cameronspears/pria-5/docs/images/bass-nearfields.png

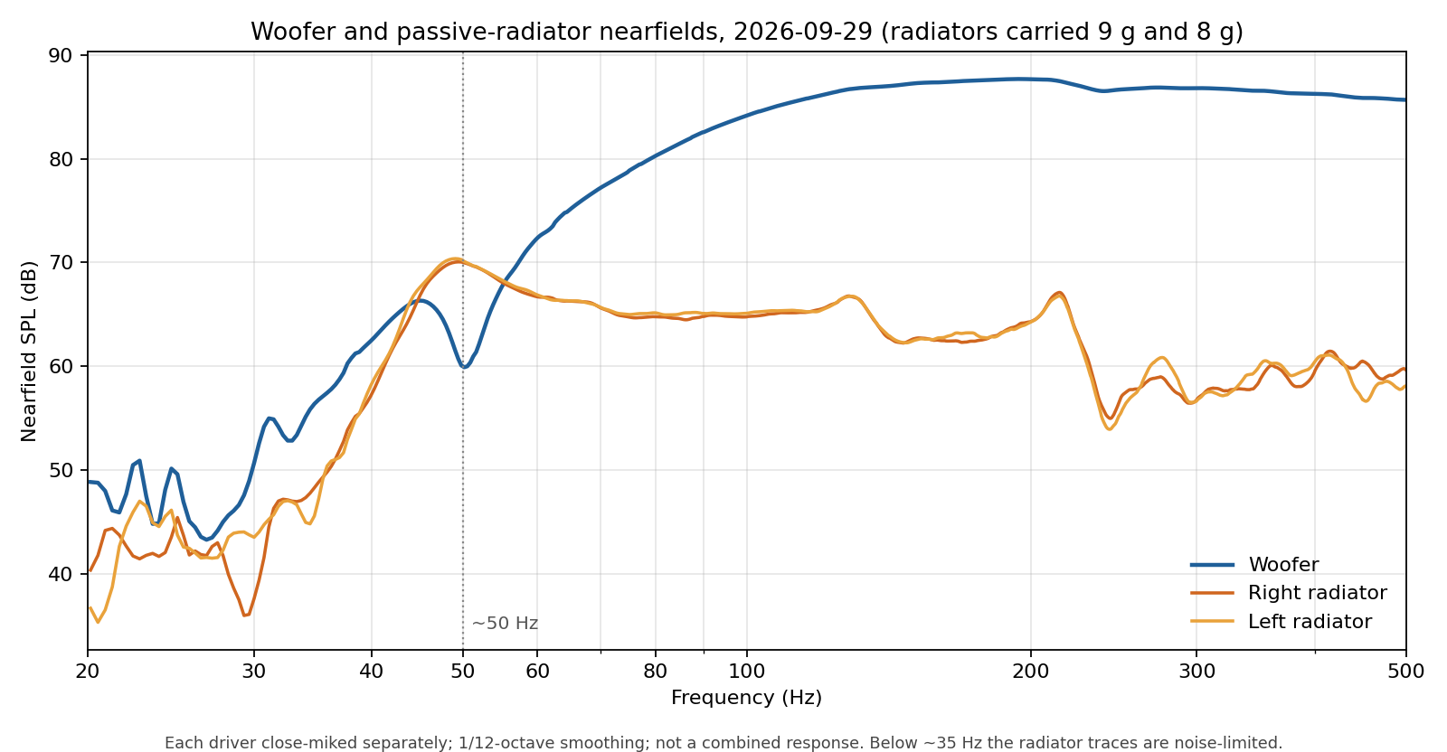
docs/images/bass-nearfields.png
