cameronspears/pria-5/docs/images/horizontal-30deg.png

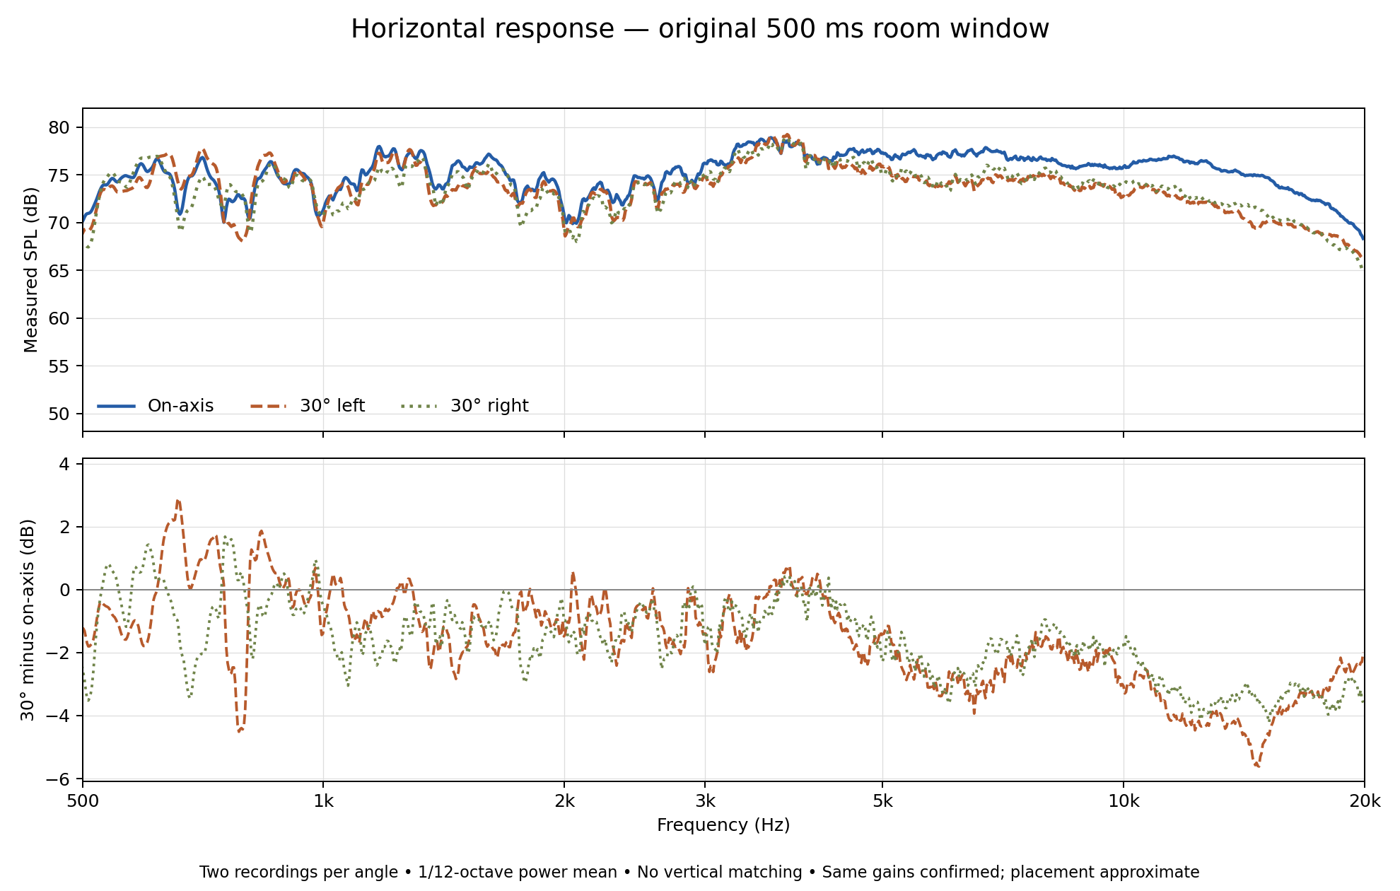
docs/images/horizontal-30deg.png
