cameronspears/pria-5/docs/images/tweeter-delay.png

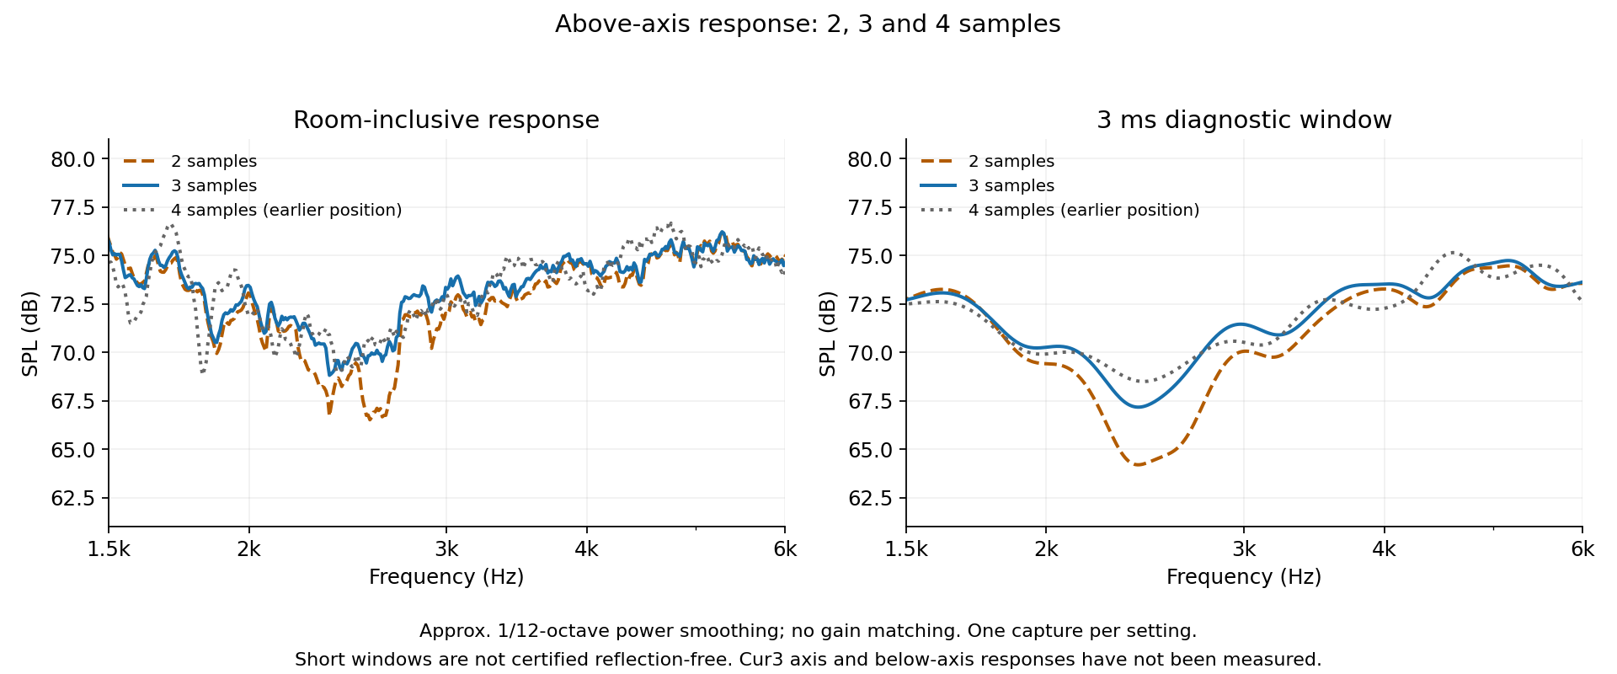
docs/images/tweeter-delay.png
