cameronspears/pria-5/simulation/crossover_study_2026-10-21/fig1_crossover.png

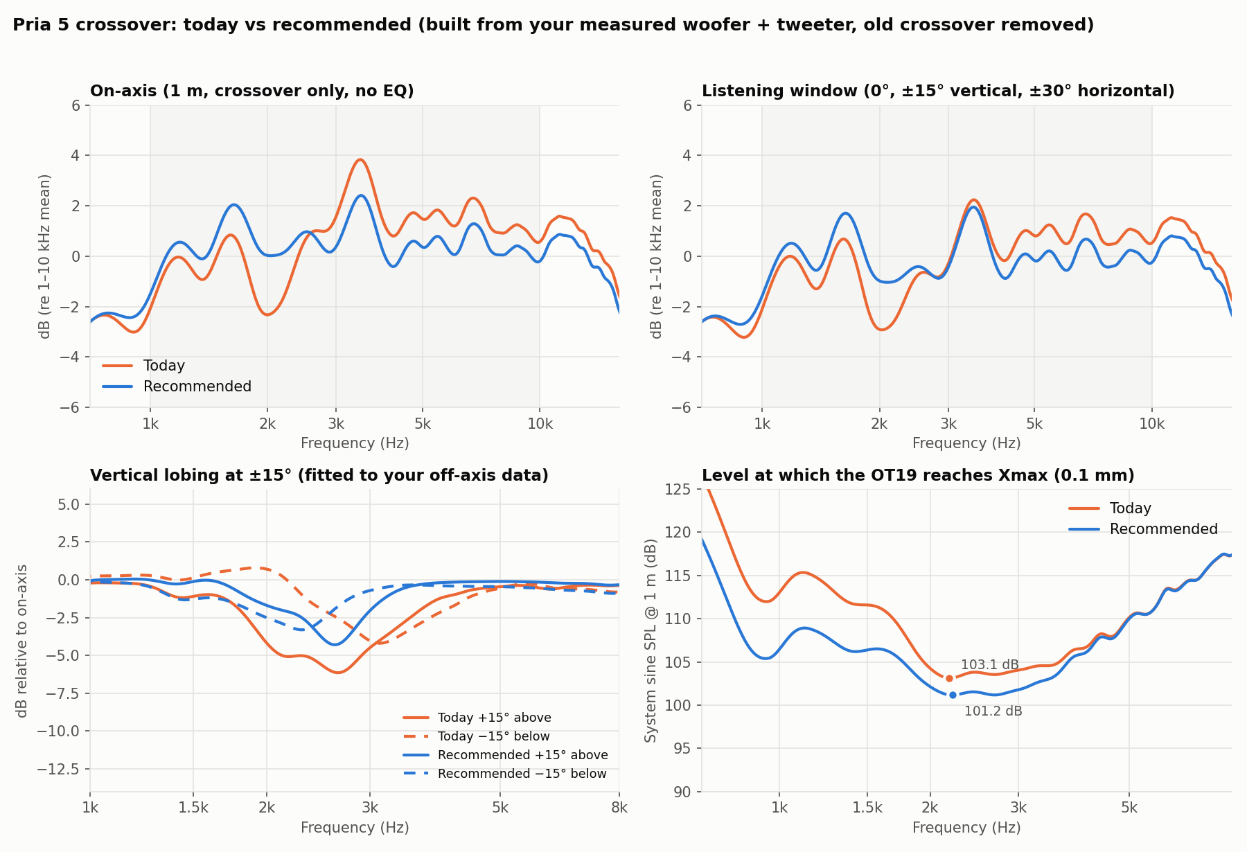
simulation/crossover_study_2026-10-21/fig1_crossover.png
