cameronspears/pria-5/simulation/crossover_study_2026-10-21/fig2_pr_mass.png

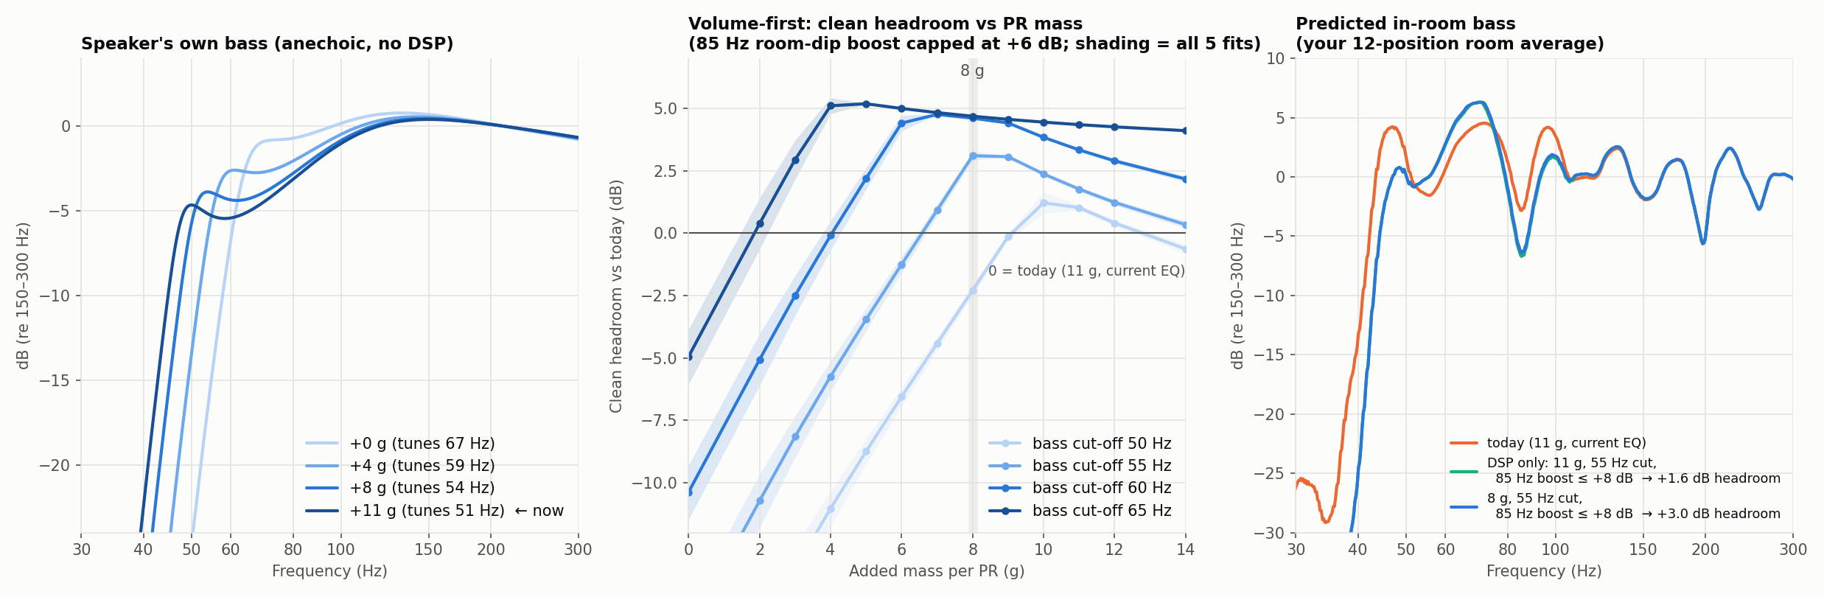
simulation/crossover_study_2026-10-21/fig2_pr_mass.png
