cameronspears/pria-5/simulation/crossover_study_2026-10-21/fig4_polarity_check.png

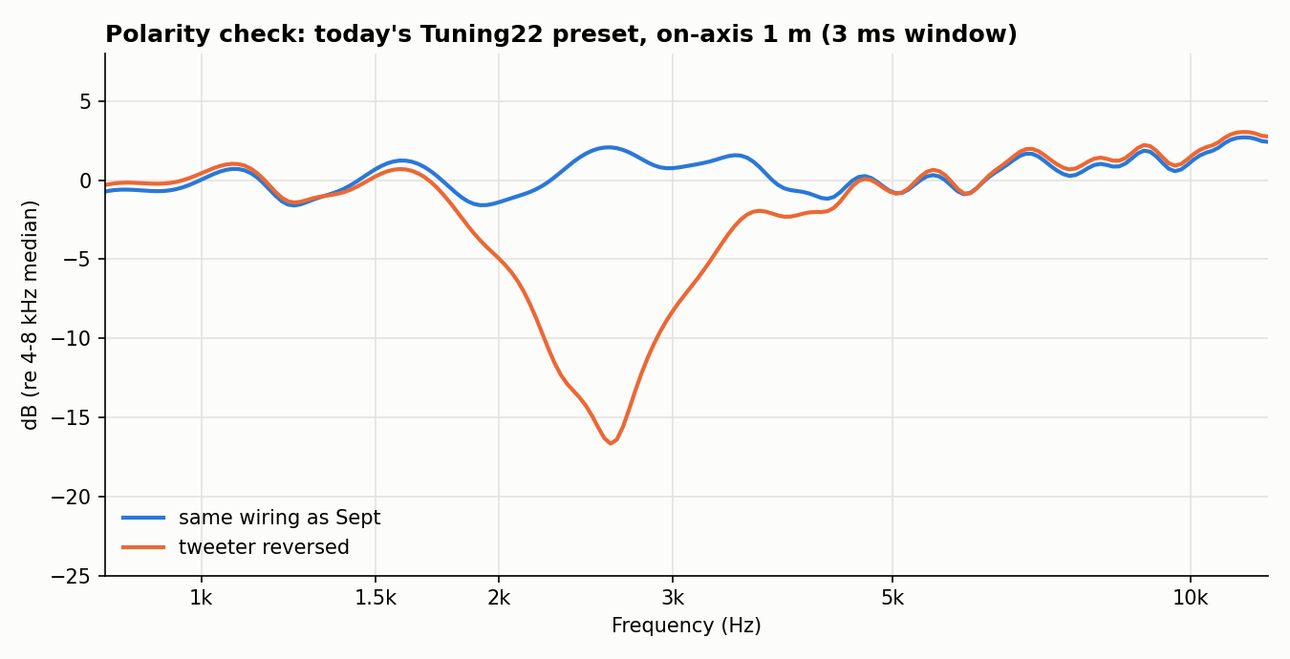
simulation/crossover_study_2026-10-21/fig4_polarity_check.png
