cameronspears/pria-5/simulation/system/full_frequency_response_comparison.png

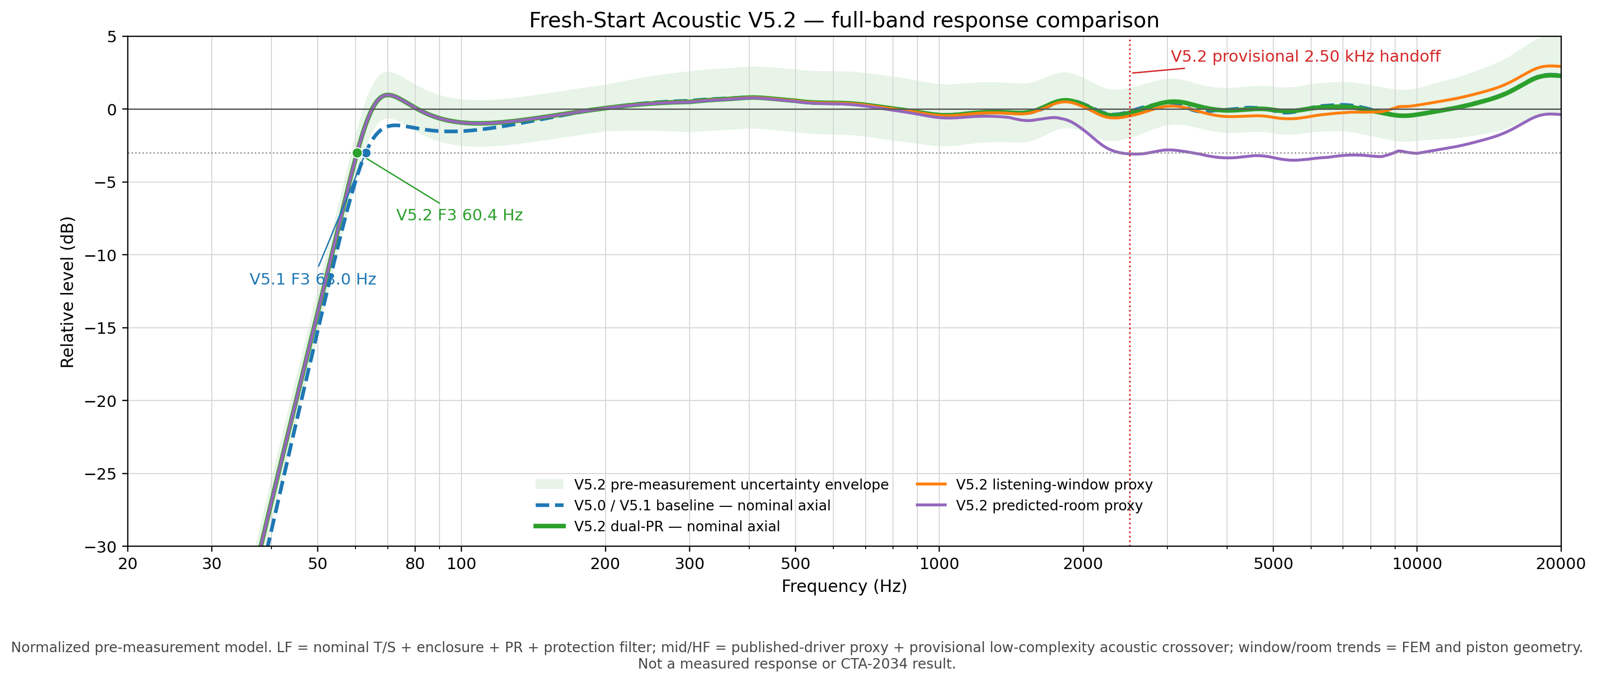
simulation/system/full_frequency_response_comparison.png
