cameronspears/pria-5/simulation/system/response_squeeze_v5_2.png

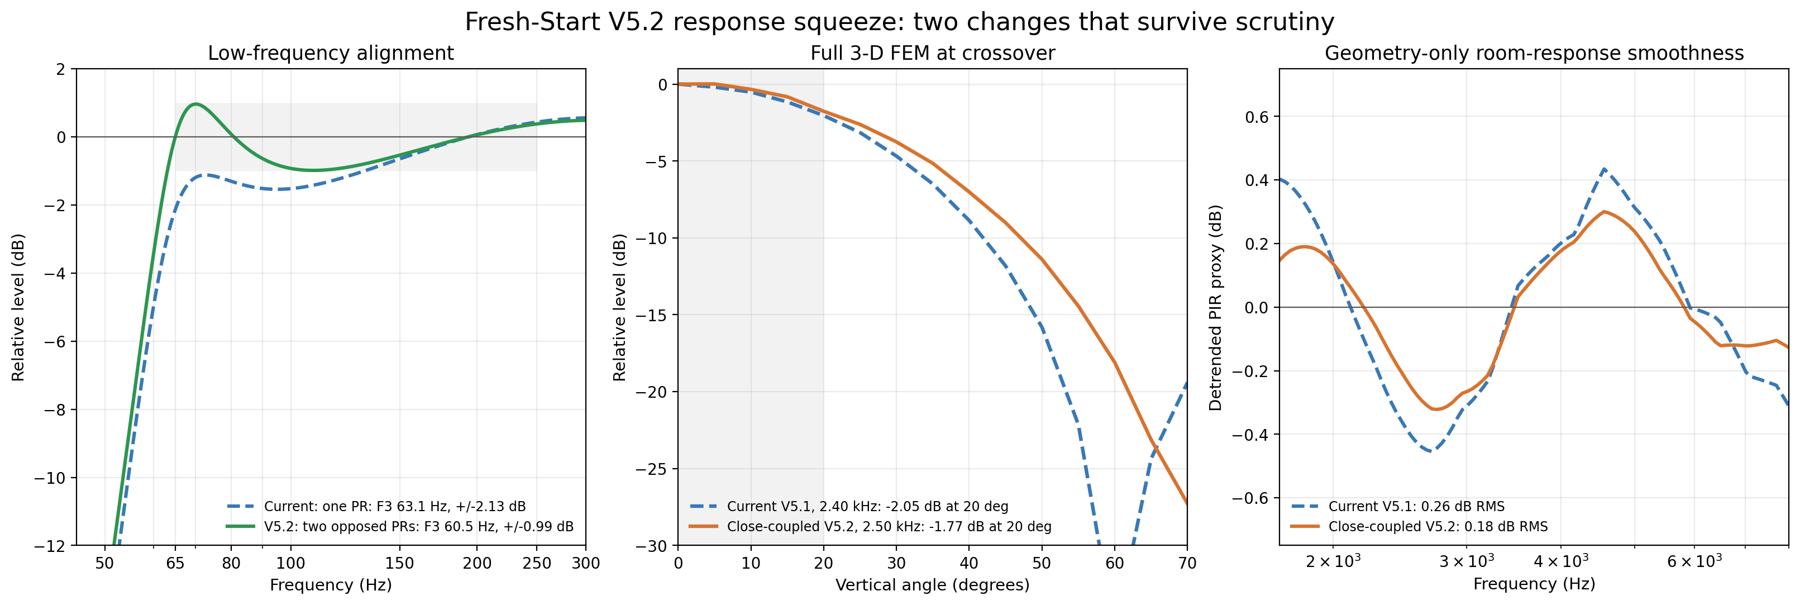
simulation/system/response_squeeze_v5_2.png
