cameronspears/pria-5/cad/bambu/Pria5_Baffle_ONLY_TABBED_pockets_ORANGE_pause44.3mf

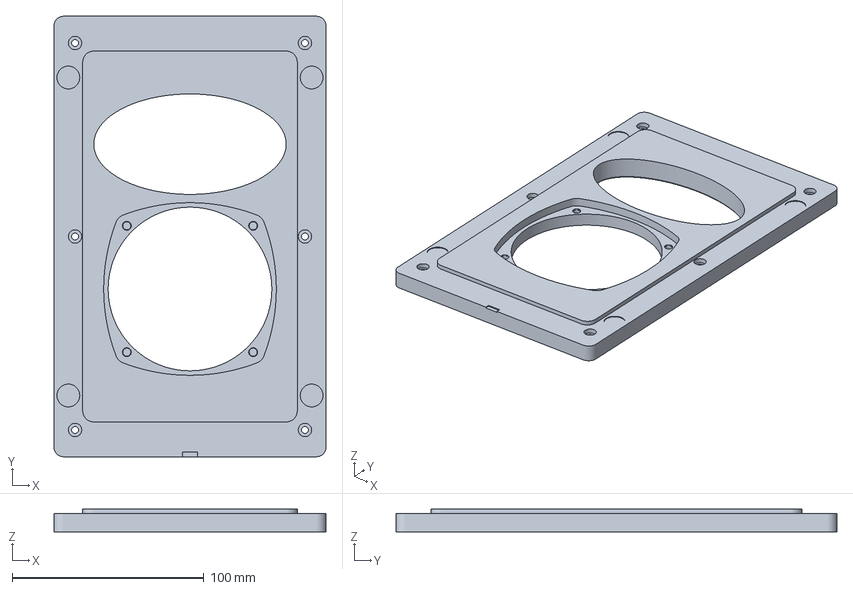
[picture p24: CAD file, 2026-10-29]
cad/bambu/Pria5_Baffle_ONLY_TABBED_pockets_ORANGE_pause44.3mf
142.0 x 230.0 x 12.0 mm
