cameronspears/pria-5/cad/gaskets/gasket_cut_template_1to1.dxf

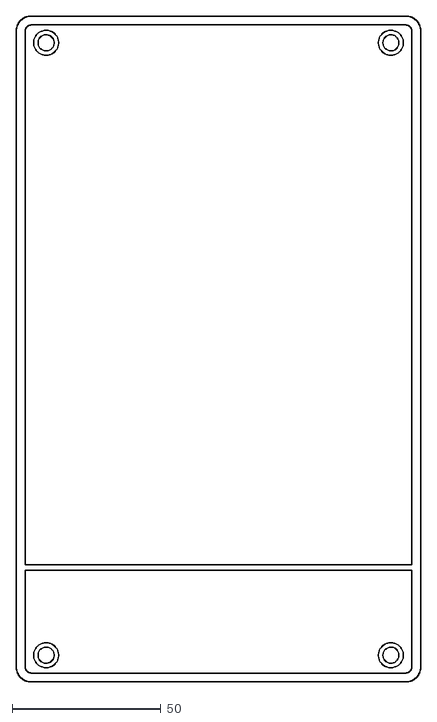
[picture p25: CAD file, 2026-10-29]
cad/gaskets/gasket_cut_template_1to1.dxf
136.0 x 224.0
