cameronspears/pria-5/cad/optional_checks/Optional_Recess_Release_Check.stl

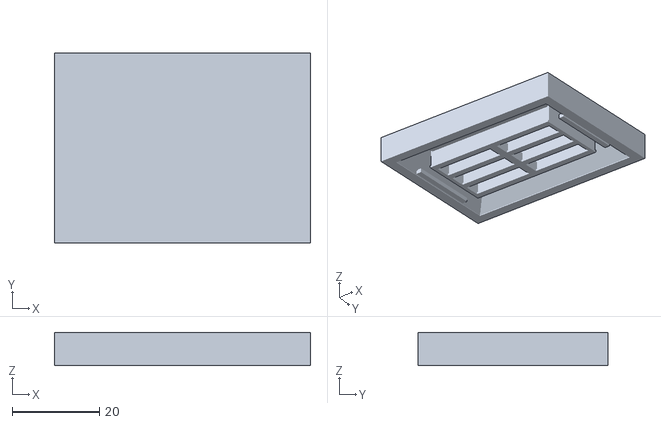
[picture p26: CAD file, 2026-10-29]
cad/optional_checks/Optional_Recess_Release_Check.stl
58.6 x 43.6 x 7.60
