cameronspears/pria-5/cad/parts/magnet_seating_tool.stl

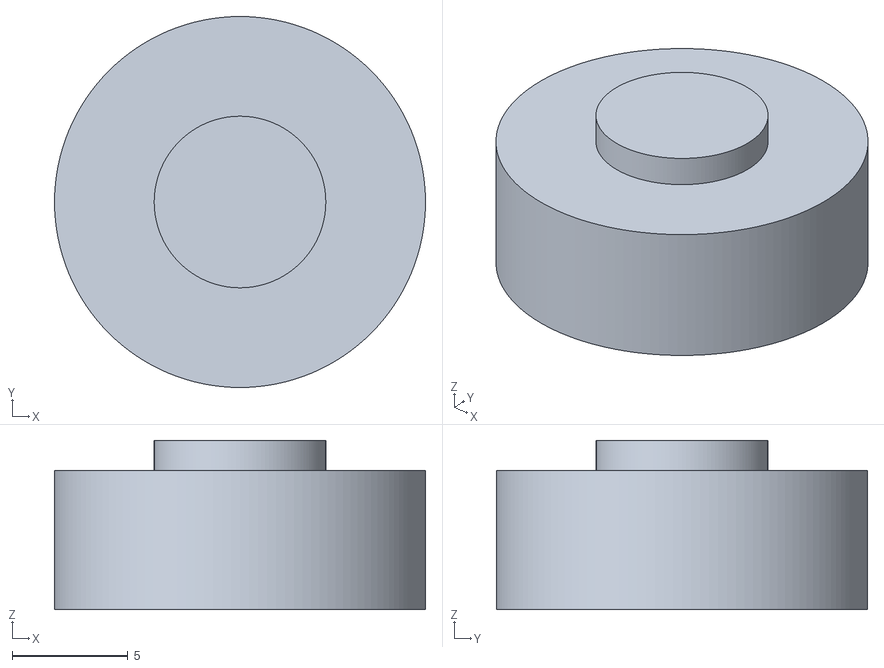
[picture p27: CAD file, 2026-10-29]
cad/parts/magnet_seating_tool.stl
16.0 x 16.0 x 7.30
