cameronspears/pria-5/cad/plates/Plate_2_Orange_MAGNETIC_FRAME_LOOSE_MAGNET_POCKETS_NO_BRIM.stl

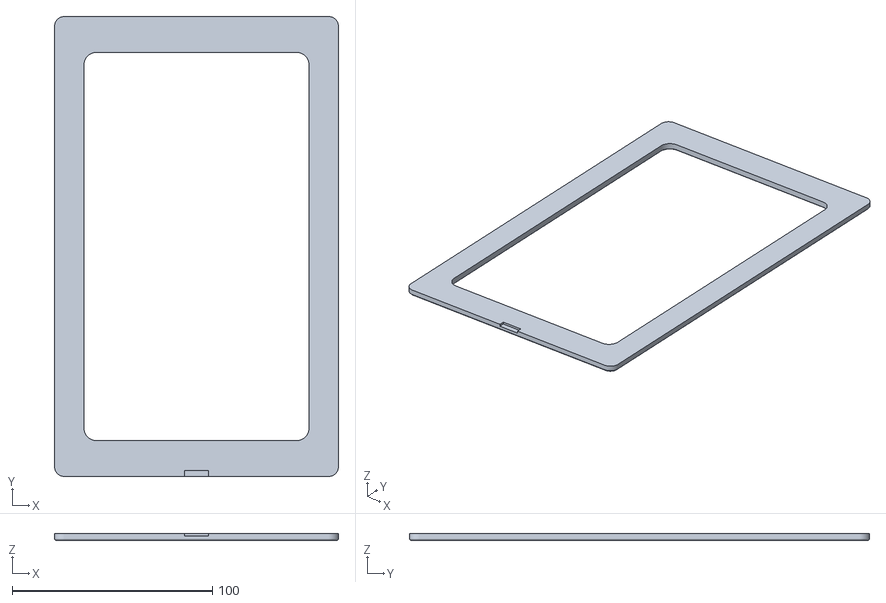
[picture p28: CAD file, 2026-10-29]
cad/plates/Plate_2_Orange_MAGNETIC_FRAME_LOOSE_MAGNET_POCKETS_NO_BRIM.stl
142.0 x 230.0 x 3.60
