cameronspears/pria-5/cad/stand/Desk_Stand_Tilt_18deg_NO_BRIM.stl

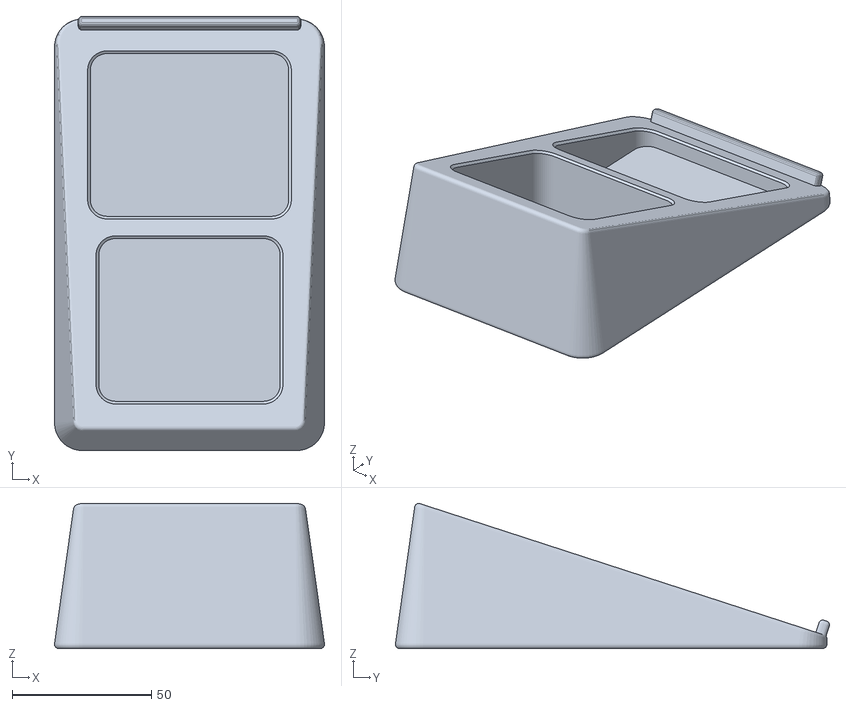
[picture p29: CAD file, 2026-10-29]
cad/stand/Desk_Stand_Tilt_18deg_NO_BRIM.stl
97.0 x 155.9 x 52.1
