cameronspears/pria-5/cad/bambu/Pria5_Plate1_Baffle_TABBED_pockets_R4_32_retainer_R4_35_wire_plate_ORANGE_pause44.3mf

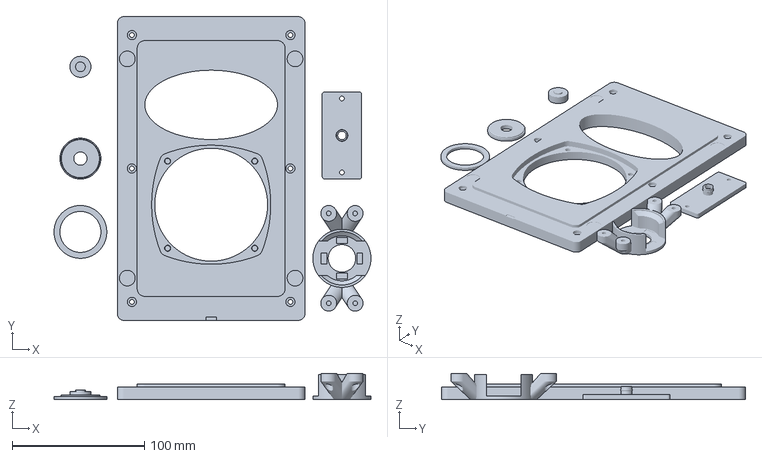
[picture p30: CAD file, 2026-10-29]
cad/bambu/Pria5_Plate1_Baffle_TABBED_pockets_R4_32_retainer_R4_35_wire_plate_ORANGE_pause44.3mf
240.0 x 230.0 x 19.9 mm
