cameronspears/pria-5/cad/optional_checks/Optional_Sealed_Magnet_Check.stl

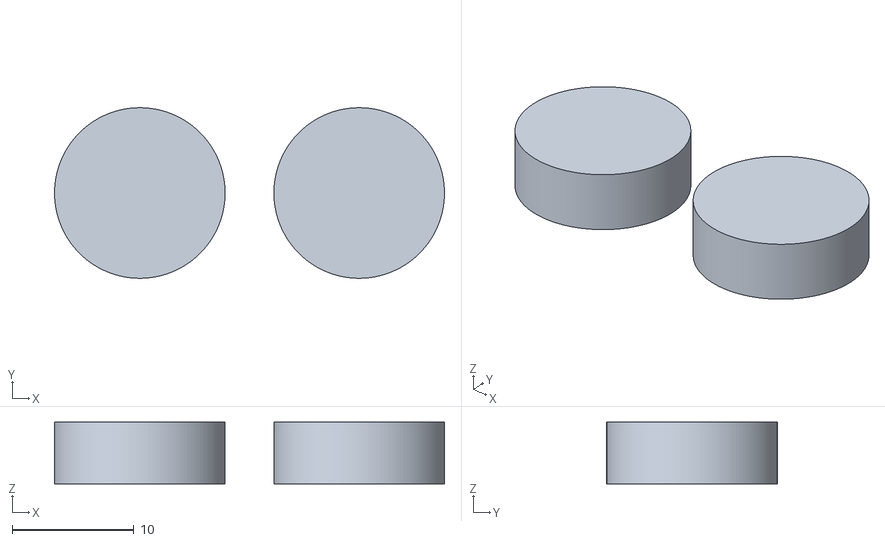
[picture p31: CAD file, 2026-10-29]
cad/optional_checks/Optional_Sealed_Magnet_Check.stl
32.0 x 14.0 x 5.05
