cameronspears/pria-5/cad/parts/retainer.stl

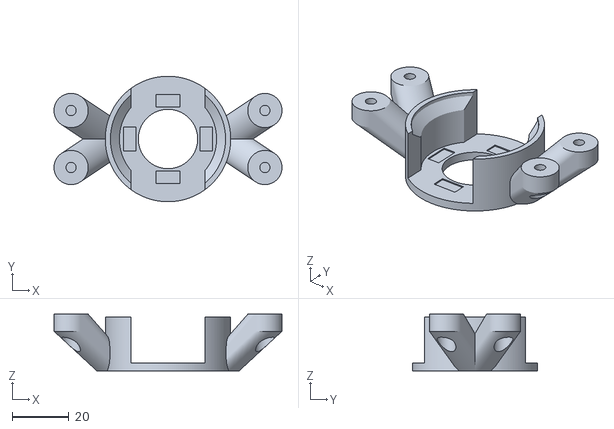
[picture p32: CAD file, 2026-10-29]
cad/parts/retainer.stl
80.0 x 44.0 x 19.9
