cameronspears/pria-5/cad/plates/Plate_4_Rear_GRILLE_VENTS_NO_BRIM.stl

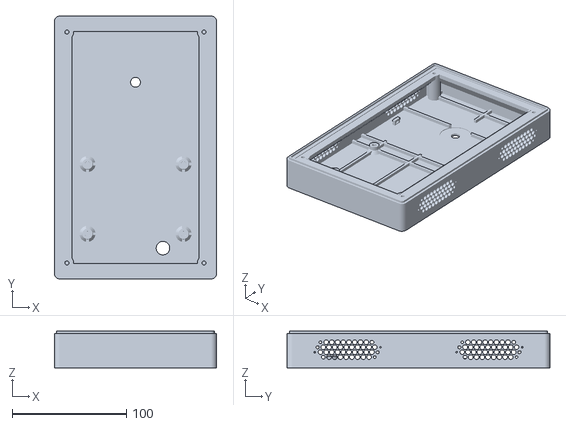
[picture p33: CAD file, 2026-10-29]
cad/plates/Plate_4_Rear_GRILLE_VENTS_NO_BRIM.stl
142.0 x 230.0 x 32.0
