cameronspears/pria-5/cad/stand/Desk_Stand_Tilt_15deg_NO_BRIM.stl

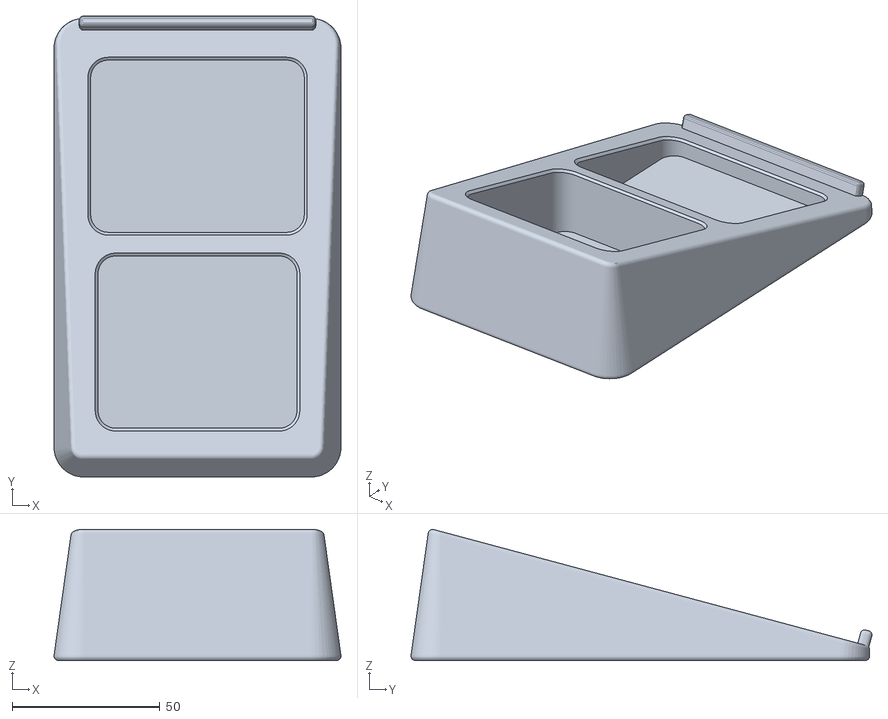
[picture p34: CAD file, 2026-10-29]
cad/stand/Desk_Stand_Tilt_15deg_NO_BRIM.stl
97.0 x 155.8 x 44.3
