cameronspears/pria-5/cad/bambu/Pria5_Tweeter_Retainer_R4_32_and_Shims.3mf

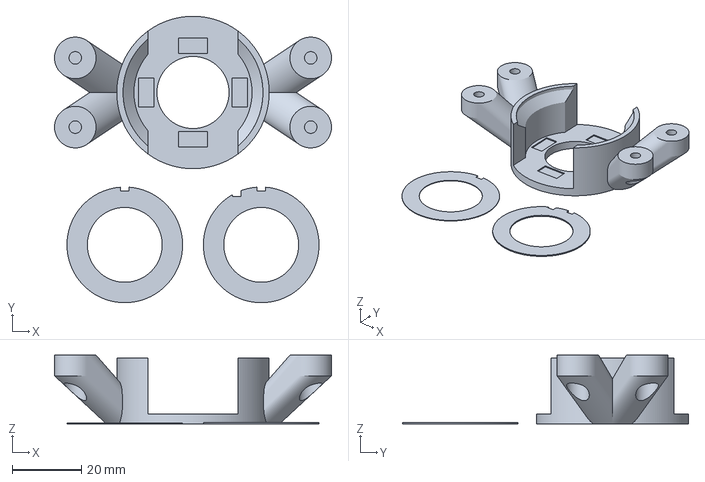
[picture p35: CAD file, 2026-10-29]
cad/bambu/Pria5_Tweeter_Retainer_R4_32_and_Shims.3mf
80.0 x 82.7 x 19.9 mm
