cameronspears/pria-5/cad/plates/Plate_5_Black_Woofer_Cover_Waveguide_NO_BRIM.stl

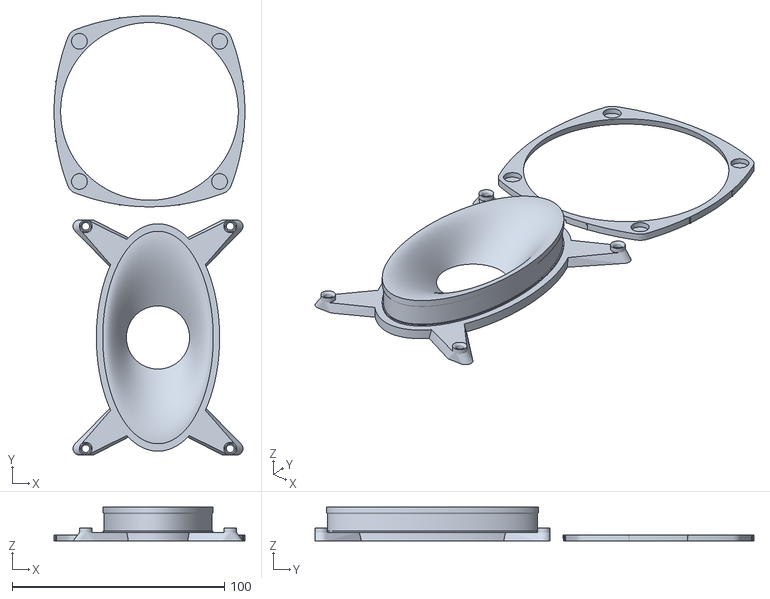
[picture p36: CAD file, 2026-10-29]
cad/plates/Plate_5_Black_Woofer_Cover_Waveguide_NO_BRIM.stl
89.8 x 206.6 x 16.0
