cameronspears/pria-5/cad/stand/Desk_Stand_Tilt_22deg_NO_BRIM.stl

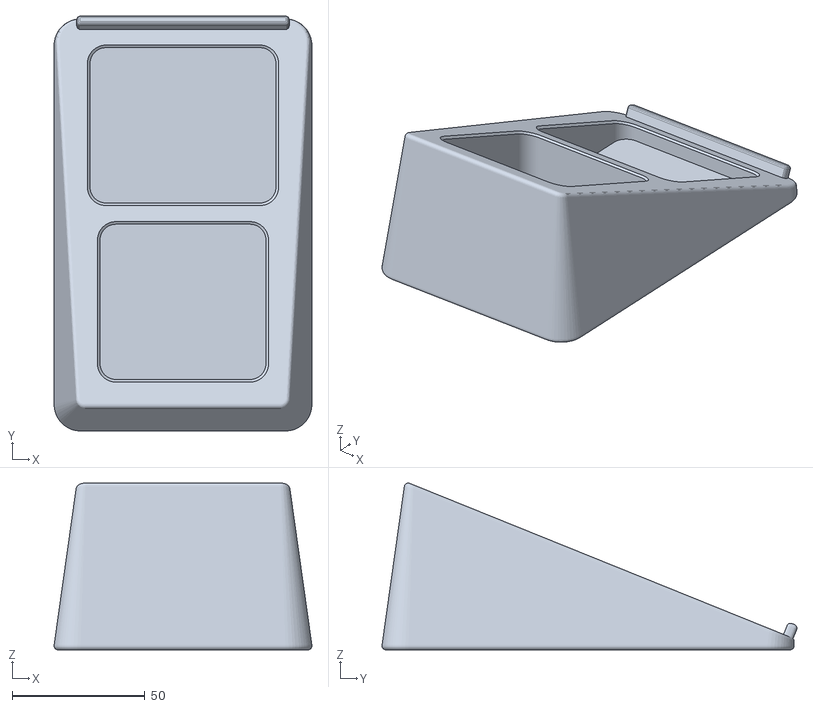
[picture p37: CAD file, 2026-10-29]
cad/stand/Desk_Stand_Tilt_22deg_NO_BRIM.stl
97.0 x 156.1 x 62.7
