cameronspears/pria-5/cad/bambu/Pria5_Wire_Plate_D6p4_HOT_GLUE_CUP_with_CHANNEL_R4_35.3mf

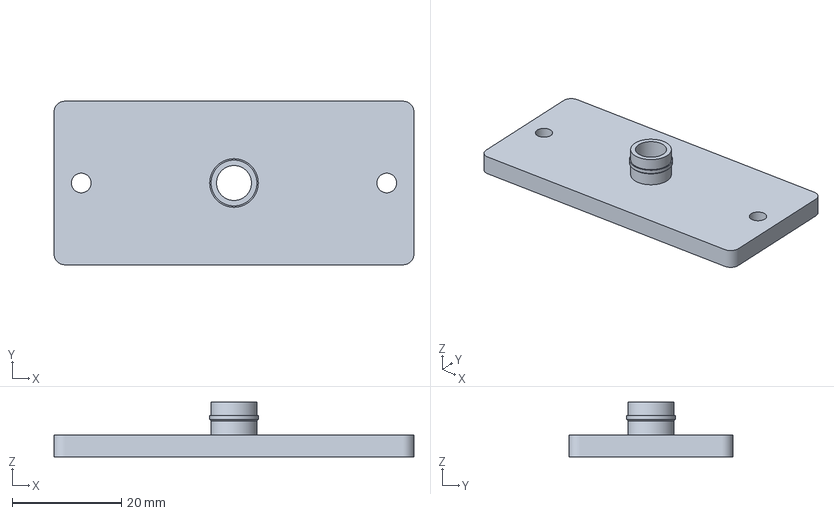
[picture p38: CAD file, 2026-10-29]
cad/bambu/Pria5_Wire_Plate_D6p4_HOT_GLUE_CUP_with_CHANNEL_R4_35.3mf
66.0 x 30.0 x 10.0 mm
