cameronspears/pria-5/cad/parts/gasket_alignment.stl

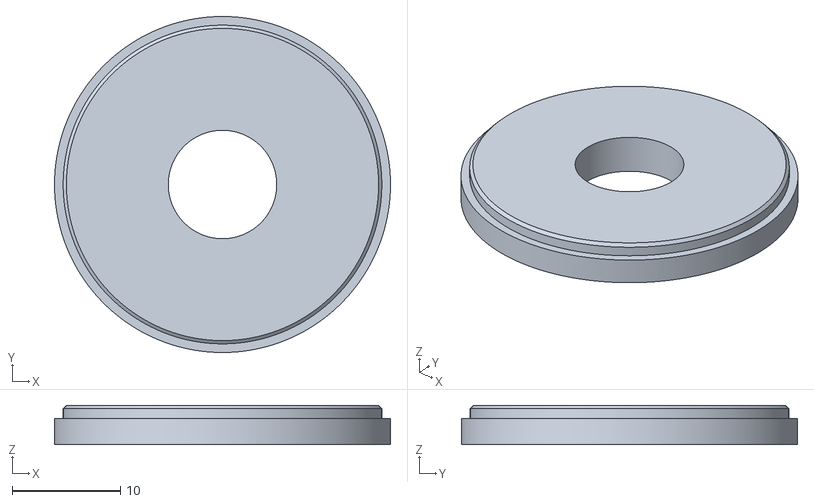
[picture p39: CAD file, 2026-10-29]
cad/parts/gasket_alignment.stl
31.0 x 31.0 x 3.60
