cameronspears/pria-5/cad/plates/Plate_3_Body_BRACED_PR_KEYS_and_3_COMBS_NO_BRIM.stl

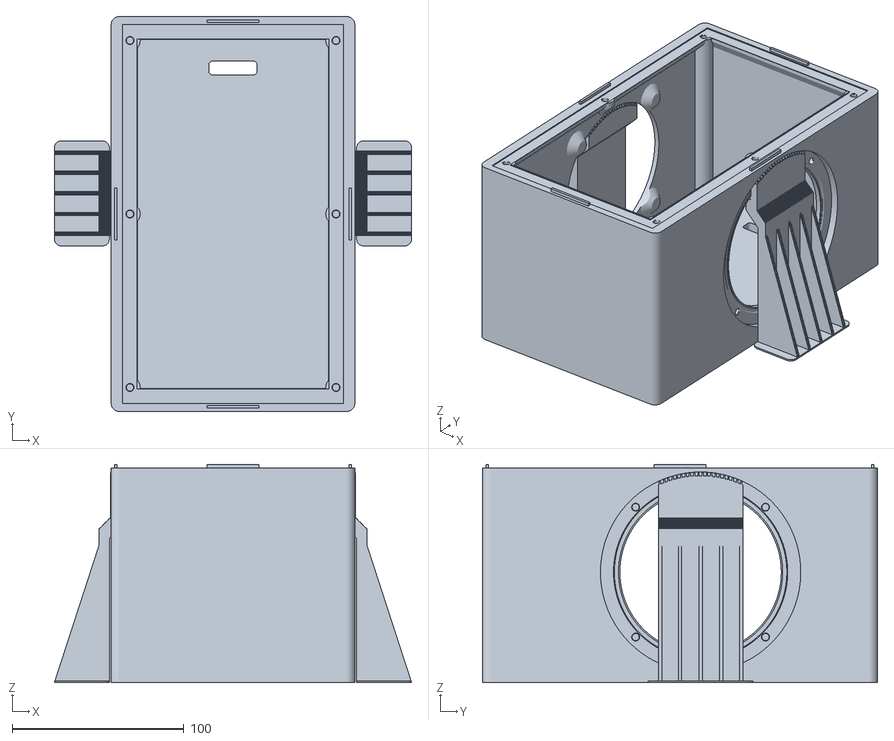
[picture p40: CAD file, 2026-10-29]
cad/plates/Plate_3_Body_BRACED_PR_KEYS_and_3_COMBS_NO_BRIM.stl
208.0 x 230.0 x 127.0
