cameronspears/pria-5/cad/bambu/Pria5_Woofer_Cover_ONLY.3mf

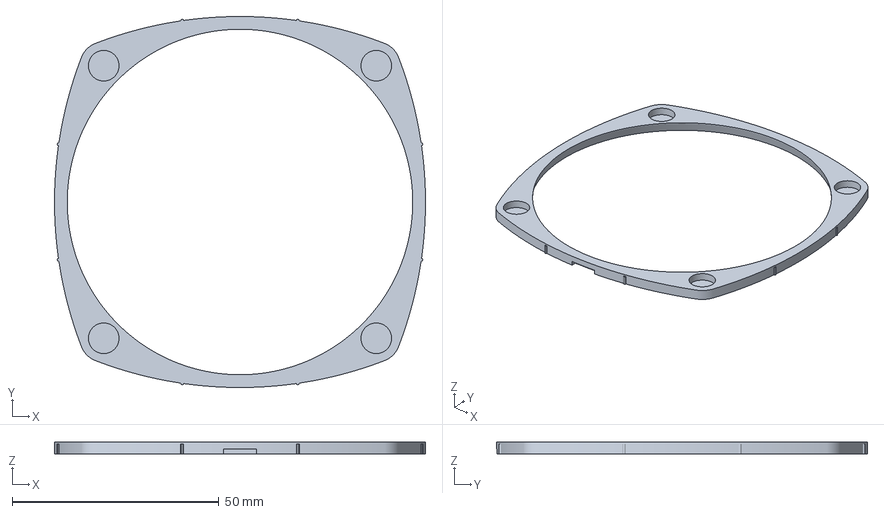
[picture p41: CAD file, 2026-10-29]
cad/bambu/Pria5_Woofer_Cover_ONLY.3mf
89.8 x 89.8 x 2.90 mm
