cameronspears/pria-5/cad/parts/waveguide.stl

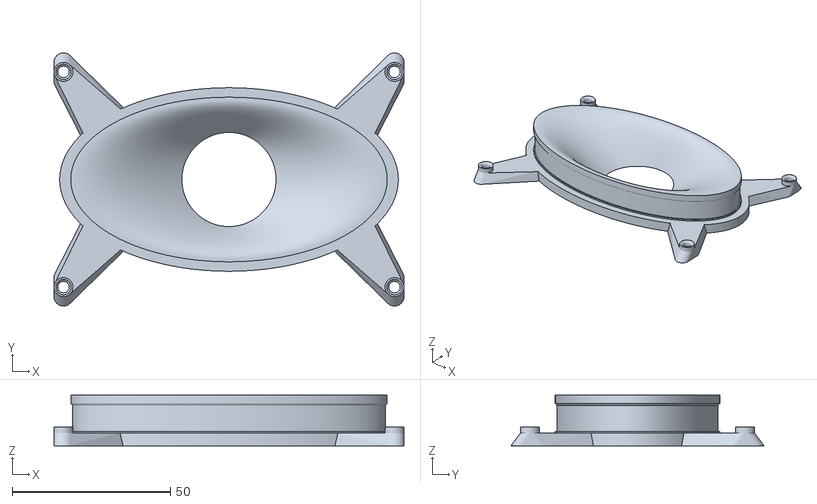
[picture p42: CAD file, 2026-10-29]
cad/parts/waveguide.stl
110.6 x 80.0 x 16.0
