cameronspears/pria-5/cad/parts/gasket_template.stl

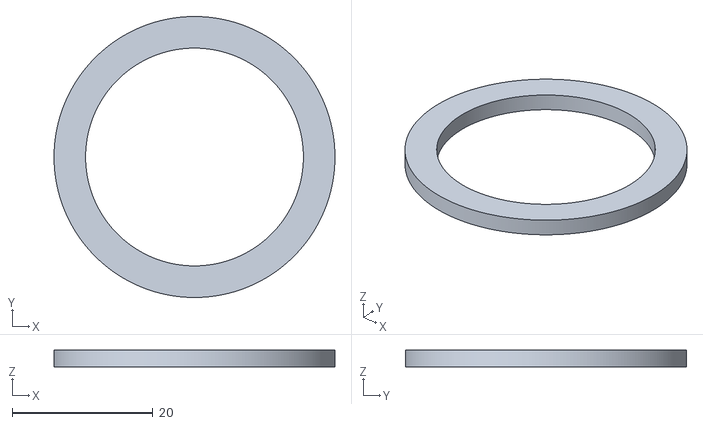
[picture p43: CAD file, 2026-10-29]
cad/parts/gasket_template.stl
40.0 x 40.0 x 2.40
