cameronspears/pria-5/cad/parts/tweeter_shims_0p2_and_0p4.stl

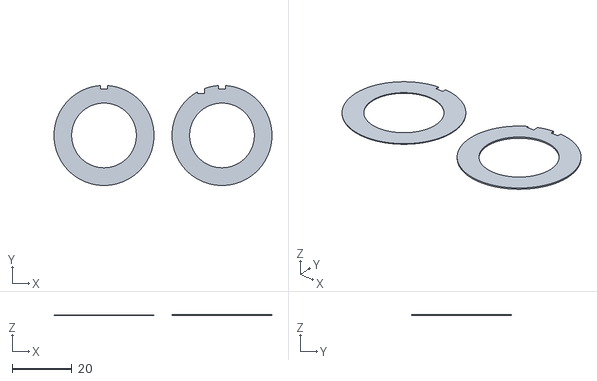
[picture p44: CAD file, 2026-10-29]
cad/parts/tweeter_shims_0p2_and_0p4.stl
72.8 x 33.4 x 0.4
