cameronspears/pria-5/(list of files, cad)

Other CAD files:
cad/plates/Plate_1_Orange_Baffle_R4_32_Retainer_R4_35_Wire_Plate_TABBED_MAGNET_POCKETS_and_SEATING_TOOL_NO_BRIM.stl
cad/bambu/Pria5_Plate2_Magnetic_Frame_ORANGE_pause17.3mf
cad/parts/baffle.stl
cad/parts/woofer_cover.stl
cad/parts/wire_plate.stl
