cameronspears/pria-5/simulation/waveguide/v5_2_close_coupled_ellipse_3d_confirmation.png

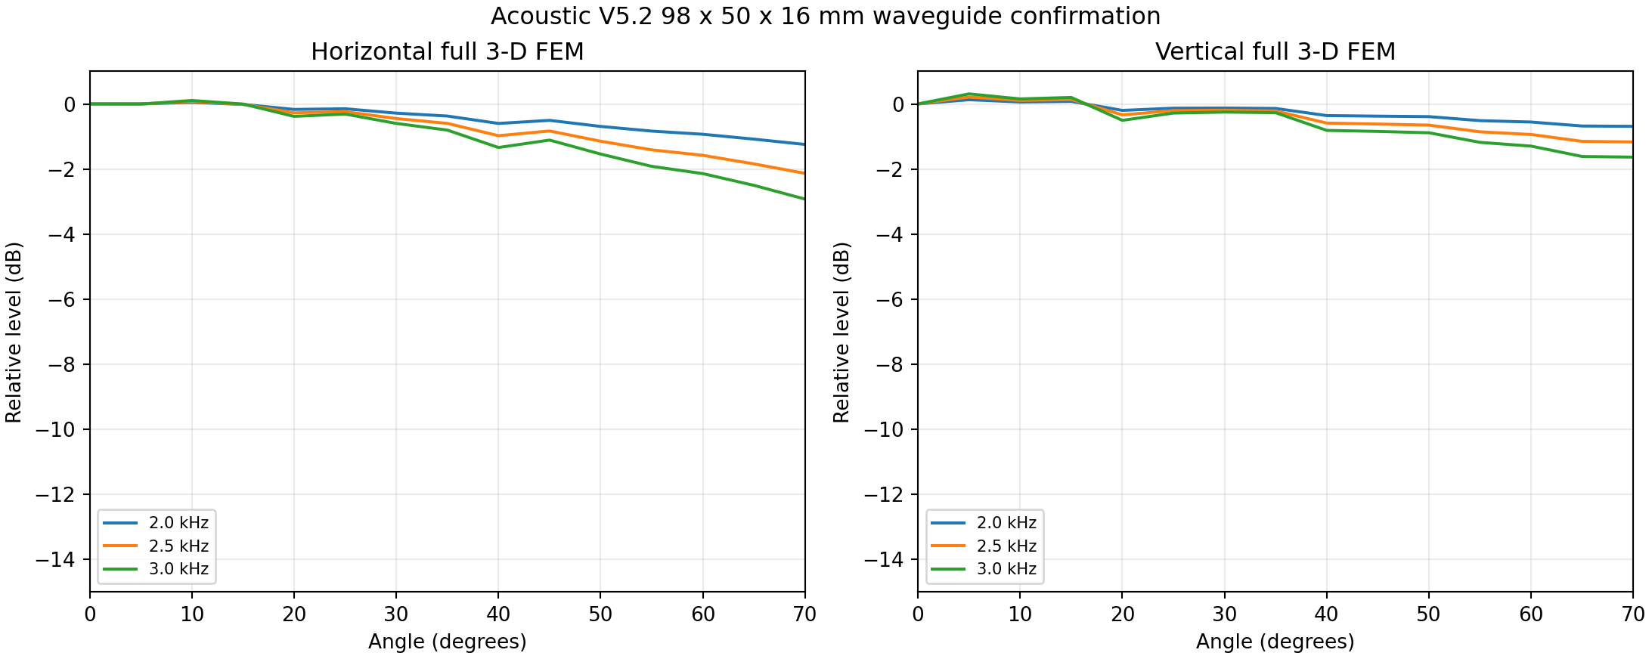
simulation/waveguide/v5_2_close_coupled_ellipse_3d_confirmation.png
