cameronspears/pria-5/dsp/tuning22/tuning22_eq.csv

block | row_1_based | type | frequency_hz | q | boost_db | gain_db | bypass
Woofer EQ | 1 | High-pass | 50.0 | 0.71 | 0.0 | 0.0 | False
Woofer EQ | 2 | High-pass | 50.0 | 0.71 | 0.0 | 0.0 | False
Woofer EQ | 3 | Peaking | 58.0 | 1.0 | 7.5 | 0.0 | False
Woofer EQ | 4 | Peaking | 69.0 | 5.0 | -9.0 | 0.0 | False
Woofer EQ | 5 | Peaking | 70.0 | 0.7 | 9.0 | 0.0 | False
Woofer EQ | 6 | Peaking | 92.0 | 2.0 | 3.0 | 0.0 | False
Woofer EQ | 7 | Peaking | 143.0 | 3.0 | -7.5 | 0.0 | False
Woofer EQ | 8 | Peaking | 220.0 | 3.5 | -4.75 | 0.0 | False
Woofer EQ | 9 | Peaking | 350.0 | 3.0 | -1.25 | 0.0 | False
Woofer EQ | 10 | Peaking | 680.0 | 3.0 | -3.75 | 0.0 | False
Woofer EQ | 11 | Peaking | 1220.0 | 6.0 | -4.0 | 0.0 | False
Woofer EQ | 12 | Peaking | 1690.0 | 1.9 | -3.0 | 0.0 | False
Woofer EQ | 13 | Peaking | 3300.0 | 3.2 | -2.0 | 0.0 | False
Woofer EQ | 14 | Peaking | 5200.0 | 1.1 | -4.0 | 0.0 | False
Woofer EQ | 15 | Peaking | 10000.0 | 0.5 | -2.5 | 0.0 | False
Tweeter EQ | 1 | Peaking | 58.0 | 1.0 | 7.5 | 0.0 | False
Tweeter EQ | 2 | Peaking | 69.0 | 5.0 | -9.0 | 0.0 | False
Tweeter EQ | 3 | Peaking | 92.0 | 2.0 | 3.0 | 0.0 | False
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
