cameronspears/pria-5/measurements/bass_nearfields_2026-09-29/left_radiator.csv

frequency_hz | nearfield_spl_db | phase_degrees
2.014160156250000000e+01 | 3.628164672851562500e+01 | -1.309374542236328125e+02
2.050781250000000000e+01 | 3.704826736450195312e+01 | -7.148912048339843750e+01
2.087402343750000000e+01 | 3.258446502685546875e+01 | -7.320524215698242188e+00
2.124023437500000000e+01 | 3.986587142944335938e+01 | 6.063074493408203125e+01
2.160644531250000000e+01 | 4.371092987060546875e+01 | 6.037001800537109375e+01
2.197265625000000000e+01 | 4.428966140747070312e+01 | 3.609401702880859375e+01
2.233886718750000000e+01 | 4.573925781250000000e+01 | -6.408696770668029785e-01
2.270507812500000000e+01 | 4.772644042968750000e+01 | -2.270698165893554688e+01
2.307128906250000000e+01 | 4.748892593383789062e+01 | -2.825422286987304688e+01
2.343750000000000000e+01 | 4.430445480346679688e+01 | -1.339805793762207031e+01
2.380371093750000000e+01 | 4.292855834960937500e+01 | 3.850396728515625000e+01
2.416992187500000000e+01 | 4.638453292846679688e+01 | 6.624150848388671875e+01
2.453613281250000000e+01 | 4.724806213378906250e+01 | 6.830274963378906250e+01
2.490234375000000000e+01 | 4.473060989379882812e+01 | 5.678084182739257812e+01
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
