cameronspears/pria-5/measurements/bass_nearfields_2026-09-29/right_radiator.csv

frequency_hz | nearfield_spl_db | phase_degrees
2.014160156250000000e+01 | 3.733570861816406250e+01 | 7.368163299560546875e+01
2.050781250000000000e+01 | 4.334106063842773438e+01 | 9.288954162597656250e+01
2.087402343750000000e+01 | 4.459657669067382812e+01 | 1.137625656127929688e+02
2.124023437500000000e+01 | 4.455698776245117188e+01 | 1.364249572753906250e+02
2.160644531250000000e+01 | 4.392259979248046875e+01 | 1.563280944824218750e+02
2.197265625000000000e+01 | 4.268309020996093750e+01 | 1.724322814941406250e+02
2.233886718750000000e+01 | 4.136124038696289062e+01 | -1.719942932128906250e+02
2.270507812500000000e+01 | 4.105704116821289062e+01 | -1.540817413330078125e+02
2.307128906250000000e+01 | 4.185068893432617188e+01 | -1.355842285156250000e+02
2.343750000000000000e+01 | 4.237442779541015625e+01 | -1.164424514770507812e+02
2.380371093750000000e+01 | 4.162840270996093750e+01 | -8.983100891113281250e+01
2.416992187500000000e+01 | 4.096103286743164062e+01 | -4.469921112060546875e+01
2.453613281250000000e+01 | 4.350529861450195312e+01 | 1.161487340927124023e+00
2.490234375000000000e+01 | 4.611326217651367188e+01 | 2.734953498840332031e+01
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
