cameronspears/pria-5/measurements/bass_nearfields_2026-09-29/woofer.csv

frequency_hz | nearfield_spl_db | phase_degrees
2.014160156250000000e+01 | 4.849197006225585938e+01 | -1.173029098510742188e+02
2.050781250000000000e+01 | 4.916970825195312500e+01 | -9.272878265380859375e+01
2.087402343750000000e+01 | 4.862674331665039062e+01 | -6.978115844726562500e+01
2.124023437500000000e+01 | 4.611678695678710938e+01 | -4.176349258422851562e+01
2.160644531250000000e+01 | 4.352800750732421875e+01 | 1.733849716186523438e+01
2.197265625000000000e+01 | 4.804252624511718750e+01 | 6.850644683837890625e+01
2.233886718750000000e+01 | 5.141685104370117188e+01 | 8.396147918701171875e+01
2.270507812500000000e+01 | 5.193179702758789062e+01 | 8.770965576171875000e+01
2.307128906250000000e+01 | 4.932038497924804688e+01 | 8.417931365966796875e+01
2.343750000000000000e+01 | 4.120707702636718750e+01 | 5.536808013916015625e+01
2.380371093750000000e+01 | 4.386558532714843750e+01 | -4.979692840576171875e+01
2.416992187500000000e+01 | 4.951196670532226562e+01 | -6.560159301757812500e+01
2.453613281250000000e+01 | 5.087559509277343750e+01 | -6.728323364257812500e+01
2.490234375000000000e+01 | 4.998041152954101562e+01 | -6.301917266845703125e+01
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
