cameronspears/pria-5/measurements/horizontal_30deg_2026-09-29/horizontal_comparison.csv

frequency_hz | axis_db | left30_db | right30_db
5.099999999999998579e+01 | 5.725022029835955095e+01 | 5.737700121886810223e+01 | 5.656104447844732164e+01
5.118444996474858044e+01 | 5.714805733975849478e+01 | 5.723729848848441293e+01 | 5.647139110167022125e+01
5.136956702340886238e+01 | 5.702384387105267649e+01 | 5.707567903509592355e+01 | 5.636218078734107451e+01
5.155535358863667739e+01 | 5.687583854622445756e+01 | 5.689133548929864048e+01 | 5.623102739693437968e+01
5.174181208181364866e+01 | 5.669970505599610533e+01 | 5.668206062606629558e+01 | 5.607111155923973200e+01
5.192894493307873205e+01 | 5.649468541977462621e+01 | 5.644692324093914237e+01 | 5.588161026753257943e+01
5.211675458135987071e+01 | 5.626070954710375105e+01 | 5.618438818871916141e+01 | 5.566100941387531975e+01
5.230524347440581323e+01 | 5.599646976619791872e+01 | 5.589196677877112052e+01 | 5.540887323707280387e+01
5.249441406881798855e+01 | 5.570497792766762046e+01 | 5.556700123797295277e+01 | 5.513029316724926332e+01
5.268426883008253725e+01 | 5.538341601488561139e+01 | 5.520473009215074001e+01 | 5.482398547302760505e+01
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
