cameronspears/pria-5/measurements/room_average_tuning12_2026-09-30/comparison.csv

frequency_hz | target_db | t11_measured_db | t12_predicted_db | t12_measured_db
2.000000000000000000e+01 | 6.913009087484374504e+01 | 5.255970329100083660e+01 | 5.291854288585922461e+01 | 4.253799287606141633e+01
2.007233331950925503e+01 | 6.912644504151042213e+01 | 5.249995485508824800e+01 | 5.285958513806909309e+01 | 4.249789174261600522e+01
2.014492824447408026e+01 | 6.912279920817708501e+01 | 5.243820416013687691e+01 | 5.279864644533810036e+01 | 4.245992221131747613e+01
2.021778572103400862e+01 | 6.911915337484374788e+01 | 5.237444213154402917e+01 | 5.273571894891028222e+01 | 4.242415287169714588e+01
2.029090669875047581e+01 | 6.911550754151041076e+01 | 5.230863681921712072e+01 | 5.267077155749004191e+01 | 4.239077127547038515e+01
2.036429213061913401e+01 | 6.911186170817708785e+01 | 5.224075215115718152e+01 | 5.260376917619847603e+01 | 4.235997276726783412e+01
2.043794297308233254e+01 | 6.910821587484375073e+01 | 5.217219426766168056e+01 | 5.253615181395353062e+01 | 4.233081772284360511e+01
2.051186018604153105e+01 | 6.910457004151041360e+01 | 5.210347837233890544e+01 | 5.246845018449227638e+01 | 4.230300340944103255e+01
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
