cameronspears/pria-5/measurements/tweeter_delay_2026-09-30/room_window.csv

frequency_hz | above2_db | above3_db | above4_db | change_3_minus_2_db
5.099999999999998579e+01 | 5.394686963611135155e+01 | 5.422921118971802912e+01 | 5.450223420622425152e+01 | 2.823415536066775644e-01
5.118444996474858044e+01 | 5.386995667721642889e+01 | 5.419494429490222842e+01 | 5.439136368563502799e+01 | 3.249876176857995347e-01
5.136956702340886238e+01 | 5.379403328144465490e+01 | 5.415521785465088556e+01 | 5.428618237479707176e+01 | 3.611845732062306524e-01
5.155535358863667739e+01 | 5.372011730303828614e+01 | 5.410872619624704782e+01 | 5.418856648702642786e+01 | 3.886088932087616854e-01
5.174181208181364866e+01 | 5.364864058554721282e+01 | 5.405113699027204177e+01 | 5.410111391498318767e+01 | 4.024964047248289489e-01
5.192894493307873205e+01 | 5.357986626176754186e+01 | 5.398159772705631099e+01 | 5.402554366906098693e+01 | 4.017314652887691295e-01
5.211675458135987071e+01 | 5.351172698745437373e+01 | 5.389743332373108586e+01 | 5.396550402228110954e+01 | 3.857063362767121362e-01
5.230524347440581323e+01 | 5.344398422583313391e+01 | 5.379844915443391073e+01 | 5.392303711633693553e+01 | 3.544649286007768296e-01
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
