cameronspears/pria-5/measurements/tweeter_delay_2026-09-30/window_3ms.csv

frequency_hz | above2_db | above3_db | above4_db | change_3_minus_2_db
5.099999999999998579e+01 | 6.060315673047259111e+01 | 6.045057167454197611e+01 | 6.031728868248350750e+01 | -1.525850559306149989e-01
5.118444996474858044e+01 | 6.060424292633248911e+01 | 6.045175761532184566e+01 | 6.031861472255205570e+01 | -1.524853110106434428e-01
5.136956702340886238e+01 | 6.060548216397509691e+01 | 6.045310792408535150e+01 | 6.032012073156853660e+01 | -1.523742398897454109e-01
5.155535358863667739e+01 | 6.060687851932614478e+01 | 6.045462667307083393e+01 | 6.032181068253049006e+01 | -1.522518462553108520e-01
5.174181208181364866e+01 | 6.060843737765257799e+01 | 6.045631909832217588e+01 | 6.032369043301456202e+01 | -1.521182793304021175e-01
5.192894493307873205e+01 | 6.061015986401991285e+01 | 6.045818628112649407e+01 | 6.032576118427340361e+01 | -1.519735828934187793e-01
5.211675458135987071e+01 | 6.061205994406240194e+01 | 6.046024226553004866e+01 | 6.032803695911572106e+01 | -1.518176785323532840e-01
5.230524347440581323e+01 | 6.061413904874741121e+01 | 6.046248849661974134e+01 | 6.033051917018075017e+01 | -1.516505521276698687e-01
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
