cameronspears/pria-5/measurements/tuning30_2026-10-22/derived/t30_bass_alignment.csv

Frequency (Hz) | Sum (dB) | Woofer (dB) | Left radiator (dB) | Right radiator (dB)
35 |  | -28.2
36 |  | -25.8
37 |  | -24.4 |  | -27.8
38 | -30.0 | -22.8 | -25.5 | -26.4
39 | -25.9 | -20.6 | -23.2 | -23.0
40 | -23.9 | -18.2 | -21.0 | -21.1
42 | -15.0 | -15.1 | -15.5 | -15.2
43 | -11.4 | -14.0 | -13.1 | -12.7
44 | -7.9 | -13.0 | -10.7 | -10.2
45 | -5.2 | -12.7 | -8.8 | -8.6
47 | -1.3 | -12.9 | -6.2 | -6.0
48 | 0.2 | -13.6 | -5.4 | -5.1
49 | 1.6 | -13.8 | -4.6 | -4.3
51 | 3.8 | -10.4 | -3.6 | -3.3
52 | 4.7 | -8.2 | -3.3 | -2.9
54 | 6.2 | -4.3 | -2.6 | -2.4
56 | 7.7 | -1.3 | -2.1 | -1.9
57 | 8.1 | -0.1 | -2.1 | -1.9
59 | 9.0 | 1.8 | -2.2 | -1.6
61 | 9.9 | 3.6 | -2.1 | -1.6
62 | 10.3 | 4.4 | -1.8 | -1.5
64 | 11.1 | 5.7 | -1.6 | -1.4
66 | 11.8 | 6.9 | -1.5 | -1.2
68 | 12.4 | 7.8 | -1.5 | -1.2
70 | 12.8 | 8.6 | -1.7 | -1.4
72 | 12.9 | 9.0 | -2.0 | -1.8
74 | 13.0 | 9.4 | -2.3 | -2.2
76 | 13.1 | 9.7 | -2.6 | -2.6
79 | 13.1 | 9.9 | -3.2 | -3.2
81 | 13.0 | 10.0 | -3.6 | -3.6
83 | 12.9 | 10.0 | -4.0 | -4.1
86 | 12.7 | 10.0 | -4.6 | -4.7
88 | 12.6 | 10.0 | -4.9 | -5.1
91 | 12.4 | 9.9 | -5.5 | -5.7
93 | 12.2 | 9.8 | -5.9 | -6.1
96 | 11.9 | 9.6 | -6.4 | -6.7
99 | 11.7 | 9.5 | -6.8 | -7.1
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
