cameronspears/pria-5/measurements/tuning30_2026-10-22/derived/t30_offaxis_deltas.csv

Frequency (Hz) | 30° left (dB re on-axis) | 30° right (dB re on-axis) | 15° up (dB re on-axis) | 15° down (dB re on-axis)
500 | -0.0 | -0.1 | -0.4 | 0.3
530 | -0.0 | -0.1 | -0.4 | 0.3
561 | -0.1 | -0.1 | -0.4 | 0.2
595 | -0.1 | -0.1 | -0.4 | 0.1
630 | -0.1 | -0.3 | -0.4 | 0.0
667 | -0.2 | -0.5 | -0.5 | -0.0
707 | -0.2 | -0.7 | -0.6 | -0.0
749 | -0.2 | -1.0 | -0.6 | 0.0
794 | -0.1 | -1.1 | -0.7 | 0.1
841 | -0.0 | -1.1 | -0.7 | 0.3
891 | 0.1 | -1.0 | -0.7 | 0.5
944 | 0.2 | -0.7 | -0.6 | 0.6
1000 | 0.2 | -0.4 | -0.4 | 0.6
1060 | 0.1 | -0.1 | -0.1 | 0.4
1120 | -0.2 | 0.0 | 0.0 | -0.1
1190 | -0.8 | -0.1 | 0.1 | -0.8
1260 | -1.3 | -0.5 | 0.0 | -1.2
1330 | -1.2 | -0.7 | 0.0 | -1.1
1410 | -0.6 | -0.7 | 0.1 | -0.6
1500 | 0.2 | -0.5 | 0.2 | -0.3
1590 | 0.6 | -0.3 | -0.0 | -0.3
1680 | 0.4 | -0.6 | -0.4 | -0.7
1780 | -0.2 | -1.3 | -0.6 | -1.1
1890 | -0.6 | -1.7 | -0.2 | -1.1
2000 | -0.3 | -1.1 | 0.4 | -0.8
2120 | -0.2 | -0.3 | 0.3 | -0.8
2240 | -0.9 | -0.5 | -0.5 | -1.3
2380 | -1.0 | -1.0 | -0.4 | -0.9
2520 | 0.2 | -0.4 | 0.2 | 0.2
2670 | 0.3 | -0.8 | -0.4 | -0.4
2830 | -0.7 | -1.9 | -0.6 | -1.2
3000 | -0.5 | -0.9 | 0.6 | -0.2
3170 | -0.3 | -1.3 | 0.1 | -1.2
3360 | -0.6 | -0.2 | -0.2 | -1.5
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
