cameronspears/pria-5/measurements/tuning30_2026-10-22/derived/t30_polarity.csv

Frequency (Hz) | Row 7 bypassed: normal polarity (dB) | Row 7 active: inverted, as built (dB)
300 | -2.2 | -1.9
318 | -1.7 | -1.4
337 | -1.2 | -0.9
357 | -0.7 | -0.5
378 | -0.3 | -0.2
400 | 0.1 | 0.2
424 | 0.4 | 0.4
449 | 0.7 | 0.6
476 | 0.8 | 0.7
505 | 0.9 | 0.7
535 | 0.9 | 0.6
566 | 0.7 | 0.4
600 | 0.4 | 0.1
636 | 0.0 | -0.2
673 | -0.4 | -0.4
714 | -0.9 | -0.6
756 | -1.3 | -0.8
801 | -1.6 | -0.8
849 | -1.6 | -0.8
899 | -1.5 | -0.8
952 | -1.5 | -1.0
1010 | -1.5 | -1.4
1070 | -1.8 | -1.9
1130 | -2.3 | -2.3
1200 | -2.9 | -2.3
1270 | -3.5 | -2.1
1350 | -3.8 | -1.8
1430 | -3.6 | -1.6
1510 | -3.2 | -1.4
1600 | -3.1 | -1.1
1700 | -3.7 | -0.6
1800 | -5.3 | -0.0
1900 | -7.8 | 0.2
2020 | -10.3 | -0.1
2140 | -12.8 | -0.0
2270 | -16.8 | 0.7
2400 | -12.7 | 0.8
2540 | -8.5 | 0.2
2690 | -4.7 | 0.9
2850 | -1.8 | 1.6
3020 | -1.3 | 0.6
3200 | -1.7 | 0.6
3390 | -1.0 | -0.5
3600 | -0.3 | 0.3
3810 | -0.3 | 0.4
4040 | -0.2 | -0.5
4280 | -0.7 | -0.4
4530 | 0.3 | -0.3
4800 | -0.8 | -0.2
5090 | 0.7 | 0.4
5390 | 1.2 | 1.7
5710 | 0.7 | 0.5
6050 | -0.1 | -0.0
6410 | 0.9 | 1.1
6790 | 1.4 | 1.2
7190 | 1.4 | 1.4
7620 | 1.3 | 1.4
8070 | 0.9 | 1.0
8550 | 0.3 | 0.4
9060 | 1.1 | 1.1
9600 | 0.1 | 0.2
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
