cameronspears/pria-5/measurements/tuning30_2026-10-22/derived/t30_room_average.csv

Frequency (Hz) | Room-free (dB) | Room average, 12 seats (dB)
38 |  | -26.7
40 | -27.1 | -20.7
42 | -18.2 | -13.5
45 | -8.4 | -8.5
48 | -3.0 | -8.8
50 | -0.4 | -8.7
53 | 2.3 | -2.1
57 | 4.9 | 2.9
60 | 6.2 | 3.4
63 | 7.5
64 |  | 1.6
67 | 8.9 | -0.1
71 | 9.7 | -2.5
76 | 9.9 | -6.7
79 |  | -9.1
80 | 9.9 | -9.3
85 | 9.6 | -5.8
90 | 9.2 | -1.8
95 | 8.8 | 0.9
101 | 8.4 | 1.8
107 | 7.9 | 1.4
113 | 7.6 | 0.9
120 | 7.2 | 1.9
127 | 7.1 | 5.7
135 | 6.2 | 7.0
143 | 5.3 | 5.0
151 | 5.2 | 2.3
160 | 4.9 | -0.2
170 | 4.9 | 5.1
180 | 4.5 | 6.9
190 | 4.5 | 5.1
202 | 4.5 | 3.2
214 | 4.8 | 4.2
226 | 3.0
227 |  | 4.3
240 | 2.0 | 1.8
254 | 2.0 | -0.6
269 | 1.8 | 0.4
285 | 1.5 | -0.0
302 | 1.4 | -0.9
320 | 1.4 | -1.3
339 | 1.4 | -0.7
359 | 1.4
360 |  | 0.9
381 | 1.2 | 0.6
403 | 0.9
404 |  | -1.3
427 | 0.4
428 |  | -1.2
453 | -0.1 | -0.4
479 | -0.6
480 |  | -1.4
508 | -0.8
509 |  | -2.6
538 | -0.7
539 |  | -0.8
570 | -0.6
571 |  | -0.2
604 | -0.5
605 |  | -0.2
640 | -0.5
641 |  | 0.7
678 | -0.5
679 |  | 1.4
718 | -0.5
719 |  | 0.9
761 | -0.6
762 |  | 0.4
806 | -0.8
807 |  | 0.3
854 | -0.8
855 |  | -0.2
905 | -0.8
906 |  | -0.9
959 | -1.1
960 |  | -2.7
1020 | -1.5 | -3.2
1080 | -2.0 | -3.1
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
