cameronspears/pria-5/measurements/tuning30_2026-10-22/derived/t30_roomfree_response.csv

Frequency (Hz) | Room-free response (dB)
40 | -27.1
42 | -18.2
45 | -8.4
48 | -3.0
50 | -0.4
53 | 2.3
57 | 4.9
60 | 6.2
63 | 7.5
67 | 8.9
71 | 9.7
76 | 9.9
80 | 9.9
85 | 9.6
90 | 9.2
95 | 8.8
101 | 8.4
107 | 7.9
113 | 7.6
120 | 7.2
127 | 7.1
135 | 6.2
143 | 5.3
151 | 5.2
160 | 4.9
170 | 4.9
180 | 4.5
190 | 4.5
202 | 4.5
214 | 4.8
226 | 3.0
240 | 2.0
254 | 2.0
269 | 1.8
285 | 1.5
302 | 1.4
320 | 1.4
339 | 1.4
359 | 1.4
381 | 1.2
403 | 0.9
427 | 0.4
453 | -0.1
479 | -0.6
508 | -0.8
538 | -0.7
570 | -0.6
604 | -0.5
640 | -0.5
678 | -0.5
718 | -0.5
761 | -0.6
806 | -0.8
854 | -0.8
905 | -0.8
959 | -1.1
1020 | -1.5
1080 | -2.0
1140 | -2.3
1210 | -2.3
1280 | -2.1
1360 | -1.7
1440 | -1.5
1520 | -1.4
1610 | -1.1
1710 | -0.5
1810 | 0.0
1920 | 0.1
2030 | -0.1
2150 | -0.0
2280 | 0.7
2420 | 0.8
2560 | 0.2
2710 | 1.1
2870 | 1.5
3040 | 0.5
3230 | 0.6
3420 | -0.7
3620 | 0.5
3840 | 0.2
4060 | -0.5
4310 | -0.3
4560 | -0.4
4830 | -0.1
5120 | 0.4
5420 | 1.7
5750 | 0.4
6090 | -0.0
6450 | 1.2
6830 | 1.2
7240 | 1.4
7670 | 1.5
8130 | 0.8
8610 | 0.4
9120 | 1.1
9670 | 0.2
10240 | 0.3
10850 | 0.1
11490 | 0.9
12180 | 0.1
12900 | 0.1
13670 | -0.2
14480 | -0.8
15340 | -1.6
16250 | -1.6
17220 | -2.7
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
