cameronspears/pria-5/docs/images/room-average-tuning12.png

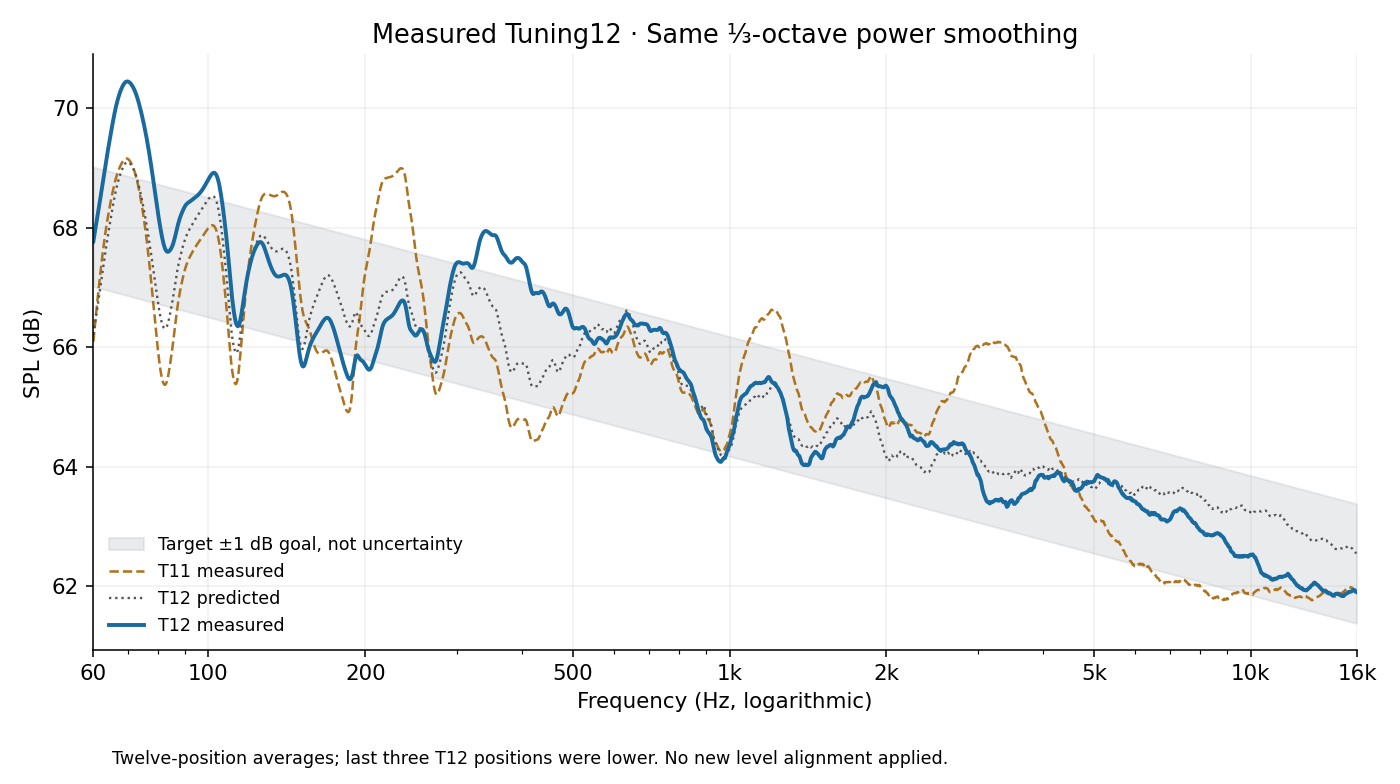
docs/images/room-average-tuning12.png
