cameronspears/pria-5/simulation/crossover_study_2026-10-21/fig3_model_validation.png

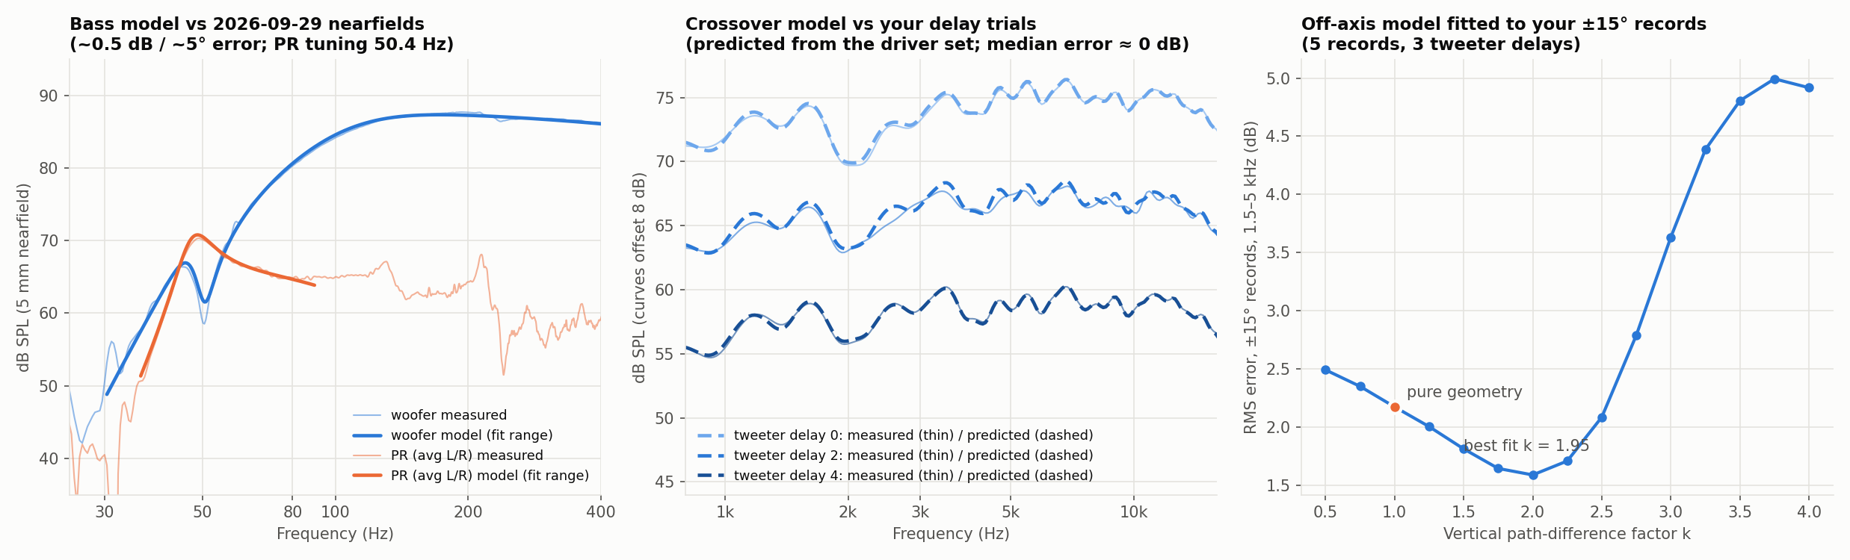
simulation/crossover_study_2026-10-21/fig3_model_validation.png
