cameronspears/pria-5/(commit log)

2026-10-29 Publish Pria 5 speaker design
    [Desk_Stand_Tilt_15deg_NO_BRIM.stl, Desk_Stand_Tilt_18deg_NO_BRIM.stl, Desk_Stand_Tilt_22deg_NO_BRIM.stl, Optional_Recess_Release_Check.stl, Optional_Sealed_Magnet_Check.stl, Plate_1_Orange_Baffle_R4_32_Retainer_R4_35_Wire_Plate_TABBED_MAGNET_POCKETS_and_SEATING_TOOL_NO_BRIM.stl, Plate_2_Orange_MAGNETIC_FRAME_LOOSE_MAGNET_POCKETS_NO_BRIM.stl, Plate_3_Body_BRACED_PR_KEYS_and_3_COMBS_NO_BRIM.stl]
2026-10-29 Bring the public repo up to Pria 5's current tuning
    The export stopped at Tuning22. The speaker now runs Tuning31, which is
    modelled from the Tuning30 measurements of 2026-10-22 and not yet measured.
    - Add the Tuning30 measurements: the performance report and the data
    behind each chart (measurements/tuning30_2026-10-22/).
    - Add the 2026-10-21 crossover, radiator-mass and speaker-preset study
    (simulation/crossover_study_2026-10-21/), without Dayton's ND91 polar
    files, and with a note on what has been corrected since.
    - Add docs/tuning-status.md, separating what was measured from what is
    predicted.
    - Rewrite dsp/ around Tuning31, with exact Tuning31 and Tuning30 EQ rows;
    move the Tu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
    [crossover_3ms_1m_midpoint.csv, inroom_full_range_1-3oct.csv, nearfield_shapes_2p7L_fit.csv, polarity_check_today_preset.csv, predicted_dsp_settings.csv, speaker_preset.csv, symmetric_search.csv, t30_bass_alignment.csv]
